742117806/CarrierProj/电力载波程序固件/(0201)carrier+wireless V1.3/readme.txt

国网13标准载波模块程序。

由于前期版本原因，本初始版本为：V4.00.

版本更新：
1、日期：20150520。
    初始版本号为V4.00。
2、日期：20150808。
    版本号：V4.03A。
    更新内容：主要更改两数据发送频率为：166.1KHz和177.1KHz ,本振为：284.0KHz.
      优化程序、屏蔽每8小时无访问时主动上报冻结数据。
3、日期：20150813
    版本号：V4.04A。
    更新内容：更改两频点为：164.4K 和 176.4K。本振为：285.7K。发送数据时，发到最后一次接收所在的时间片（相位）上去。
     
4、日期：20150819
    版本号：V4.04C
    更新内容：在单相电源上进行分时间片抄表时，底层帧可能被集中器模块解析成跨相数据。导致下次路由变成了跨相抄表。
