742117806/CarrierProj/资料/无线载波模块版本说明.docx

无线载波模块版本说明：

1、 此版本支持载波加无线，在载波发送完成后会通过无线发送（不管载波成功与否）;在接收的时候如果载波未接收到会去判断无线是否接收到，相当于载波无线同时收发。
2、 载波底层增加了对800psb的速率的支持，这由集中器路由模块决定是否使用，但是与以前版本兼容。所以默认还是最高400bps的通讯速率，采用的IO采样方式。
3、 在底层增加了纠错方式，这种方式将由集中器模块主动决定，默认是不使用的。在将来的测试中会使用。
4、 (0113)carrier+si4438 V1.2.hex文件是应用程序，是实际的载波模块（硬件版本4.04或以上）。如果硬件上不带无线座子，则只适用于载波通讯方式。
5、 此版本程序只适用于单相载波模块。
6、 (0108)si4438只用于无线测试.hex中用于无线测试使用。使用方式见相关文档。
