742117806/CarrierProj/原理图/iSPLC-9G-1X V4.06.pdf

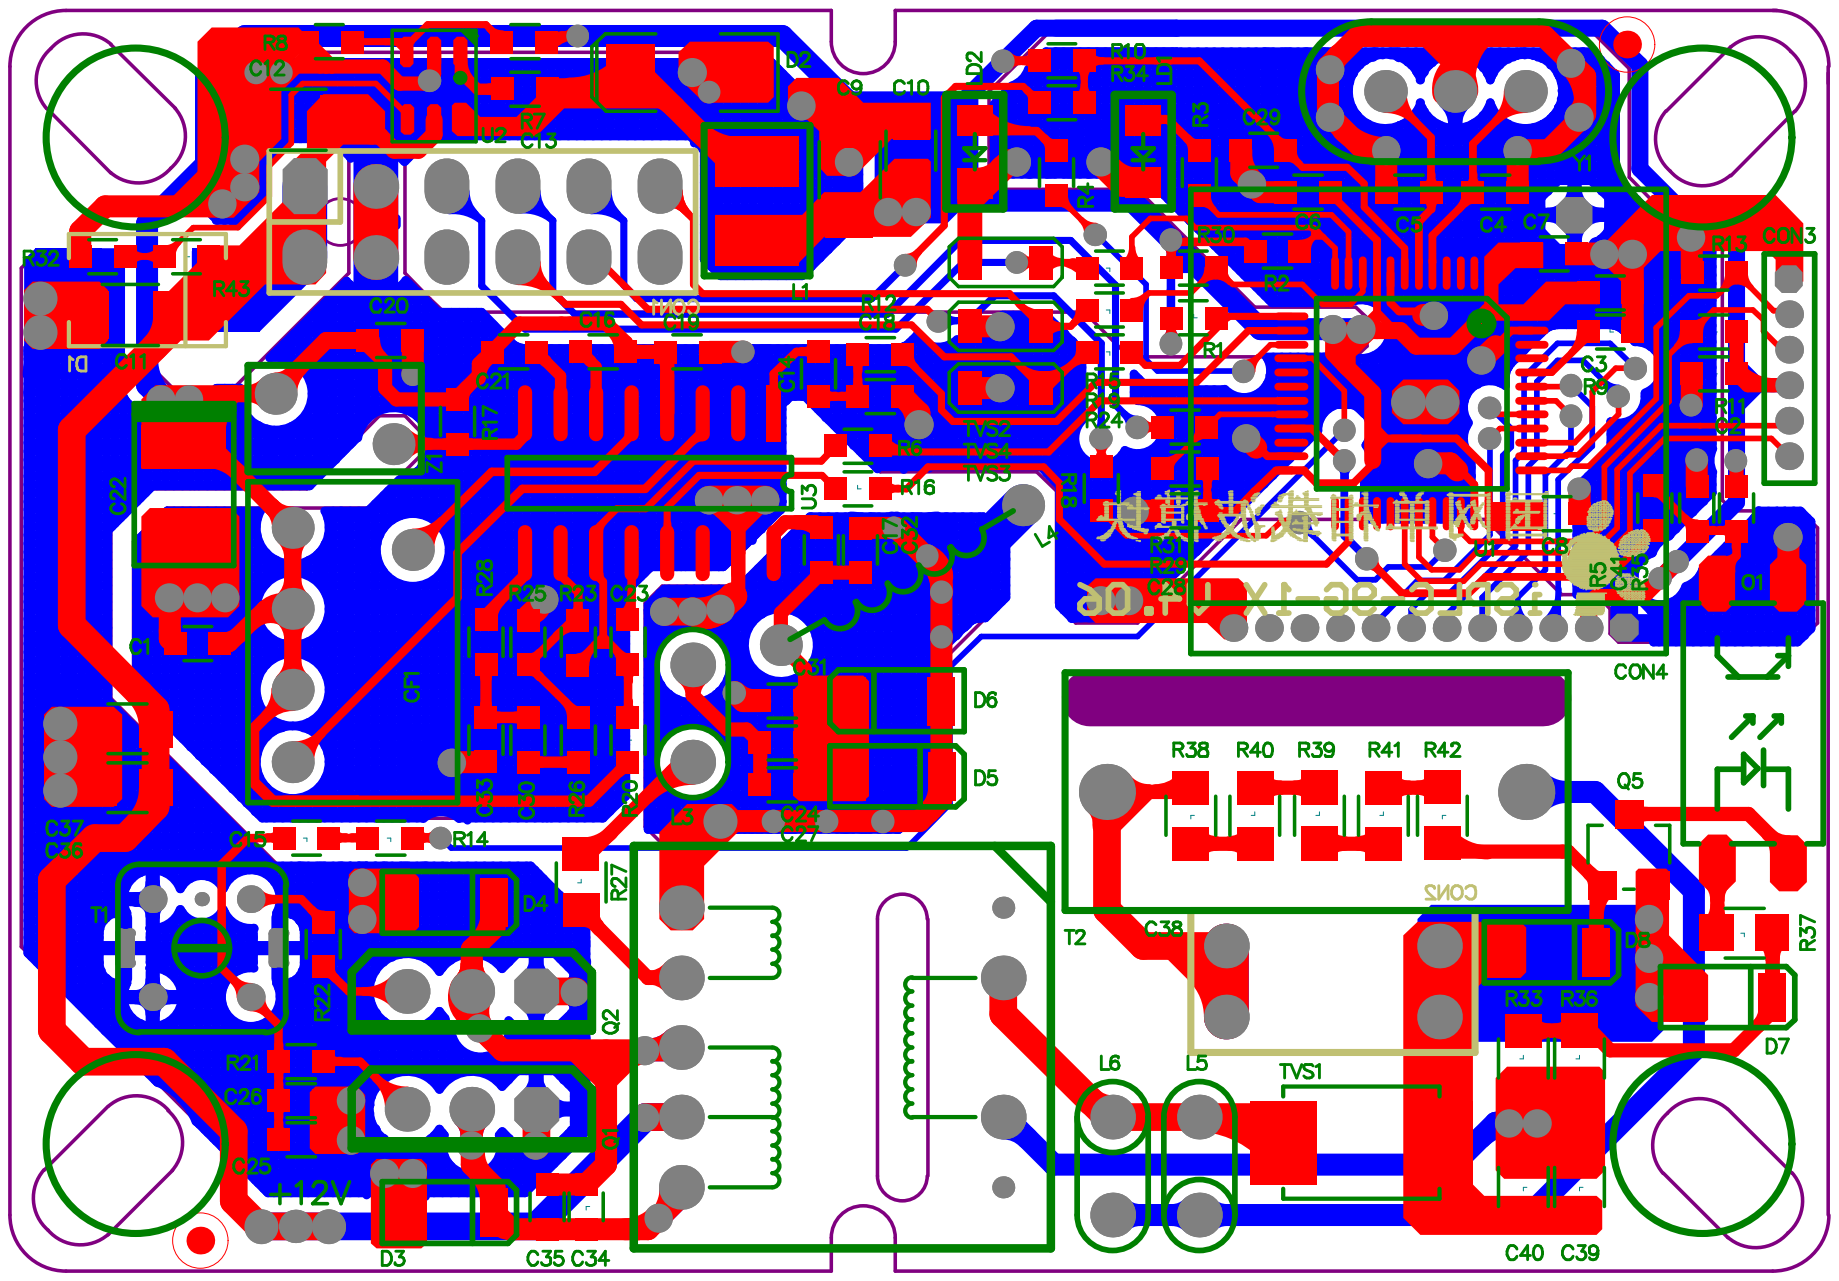
[picture p3: page 1]
