742117806/CarrierProj/原理图/零火开关/SS_dual_main-V4.2.pdf

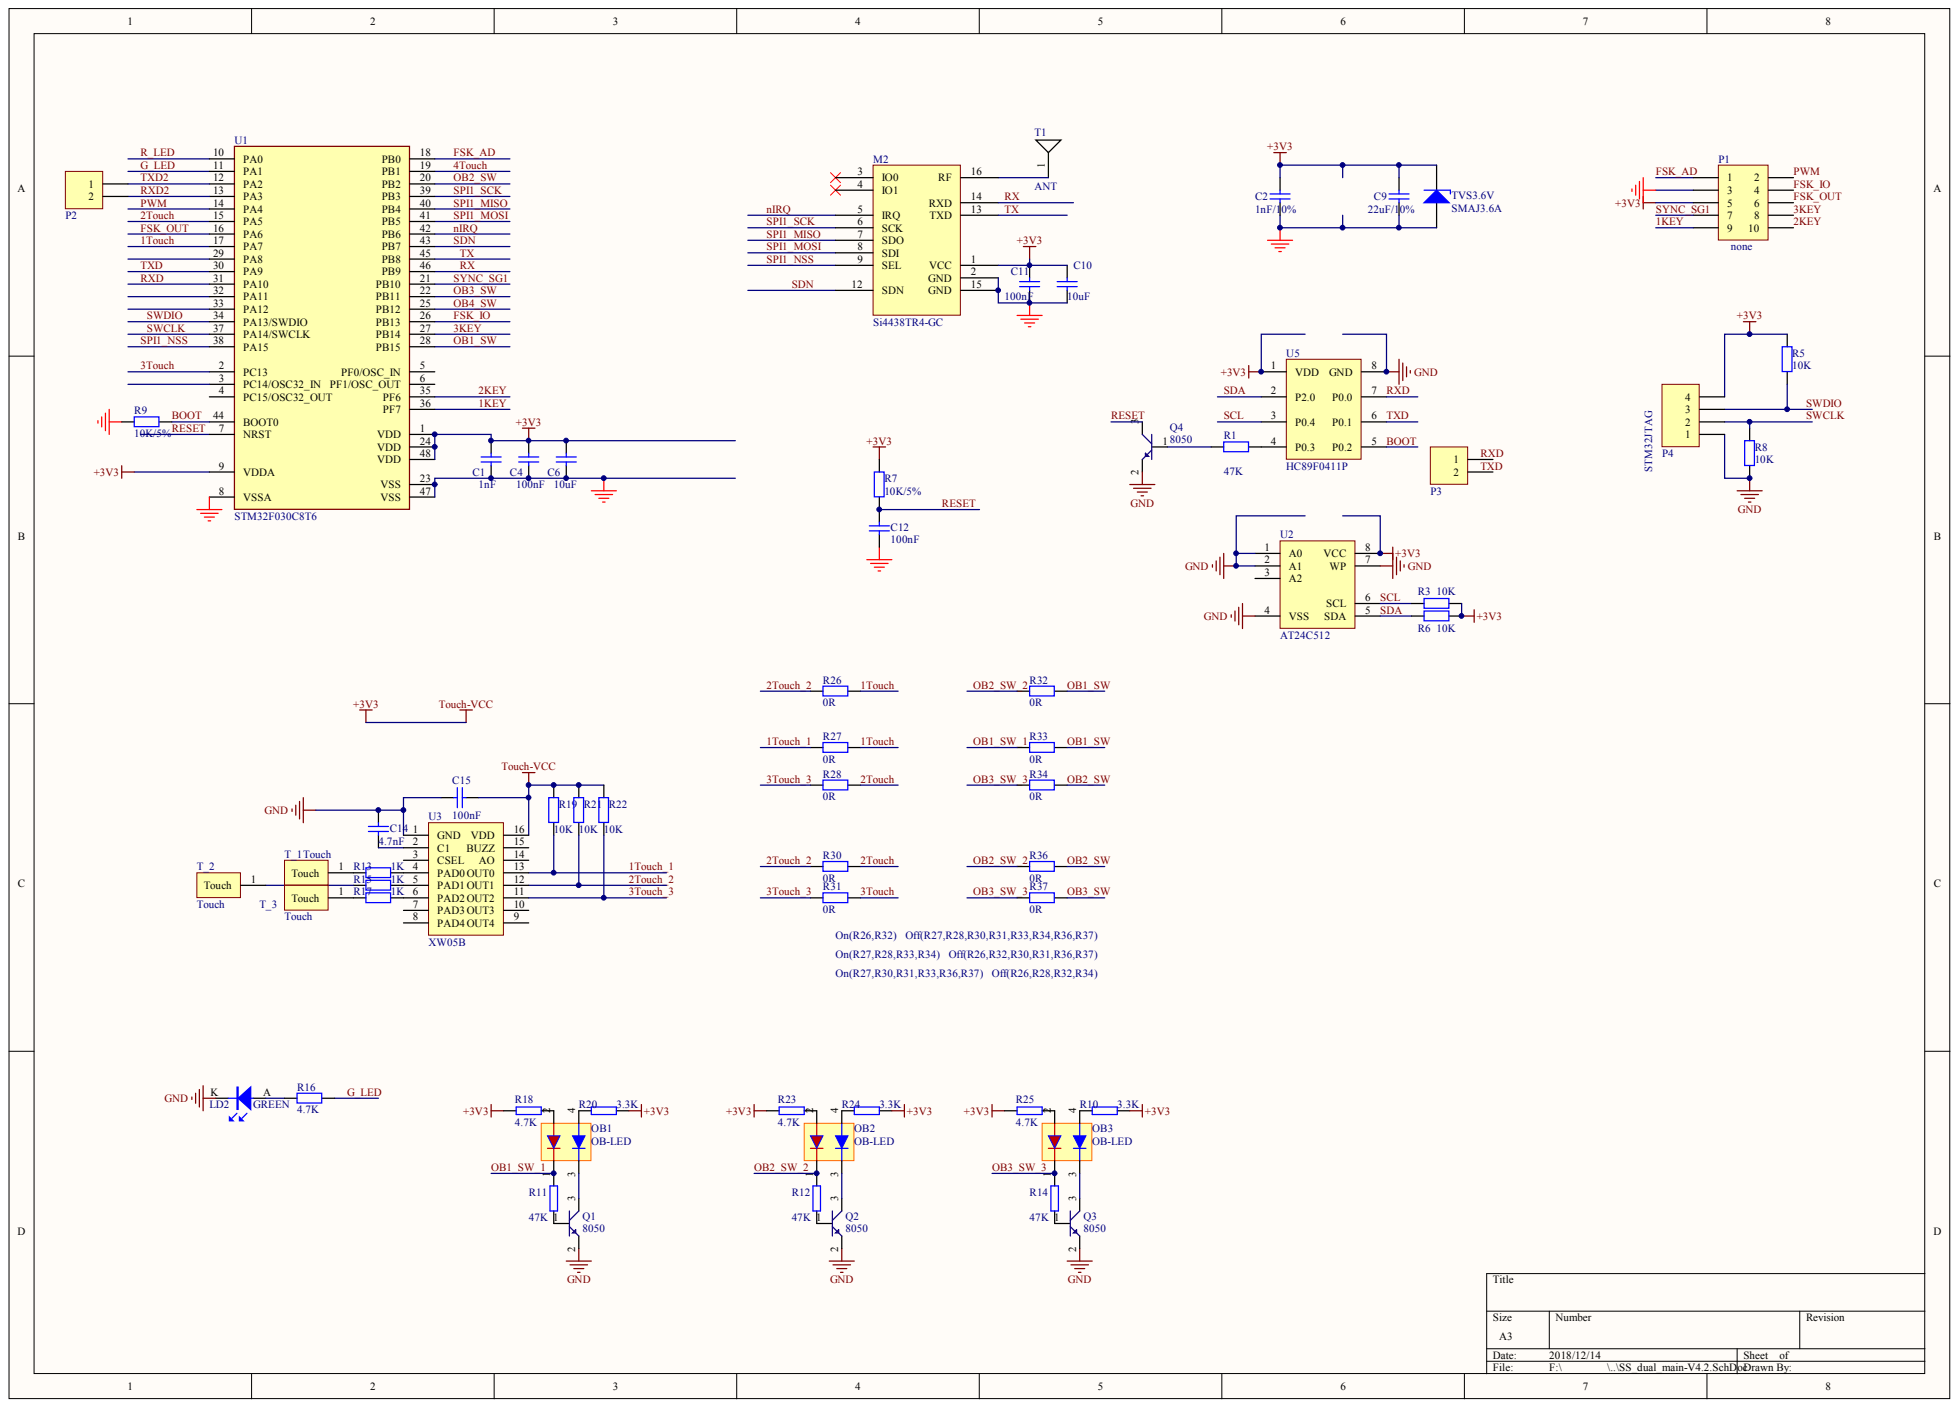
[picture p4: page 1]

R15 | 1K | PAD1 5
R17 | | 1K | PAD2 6
