742117806/CarrierProj/原理图/零火开关/SS_Power-dual_3_V4.1.pdf

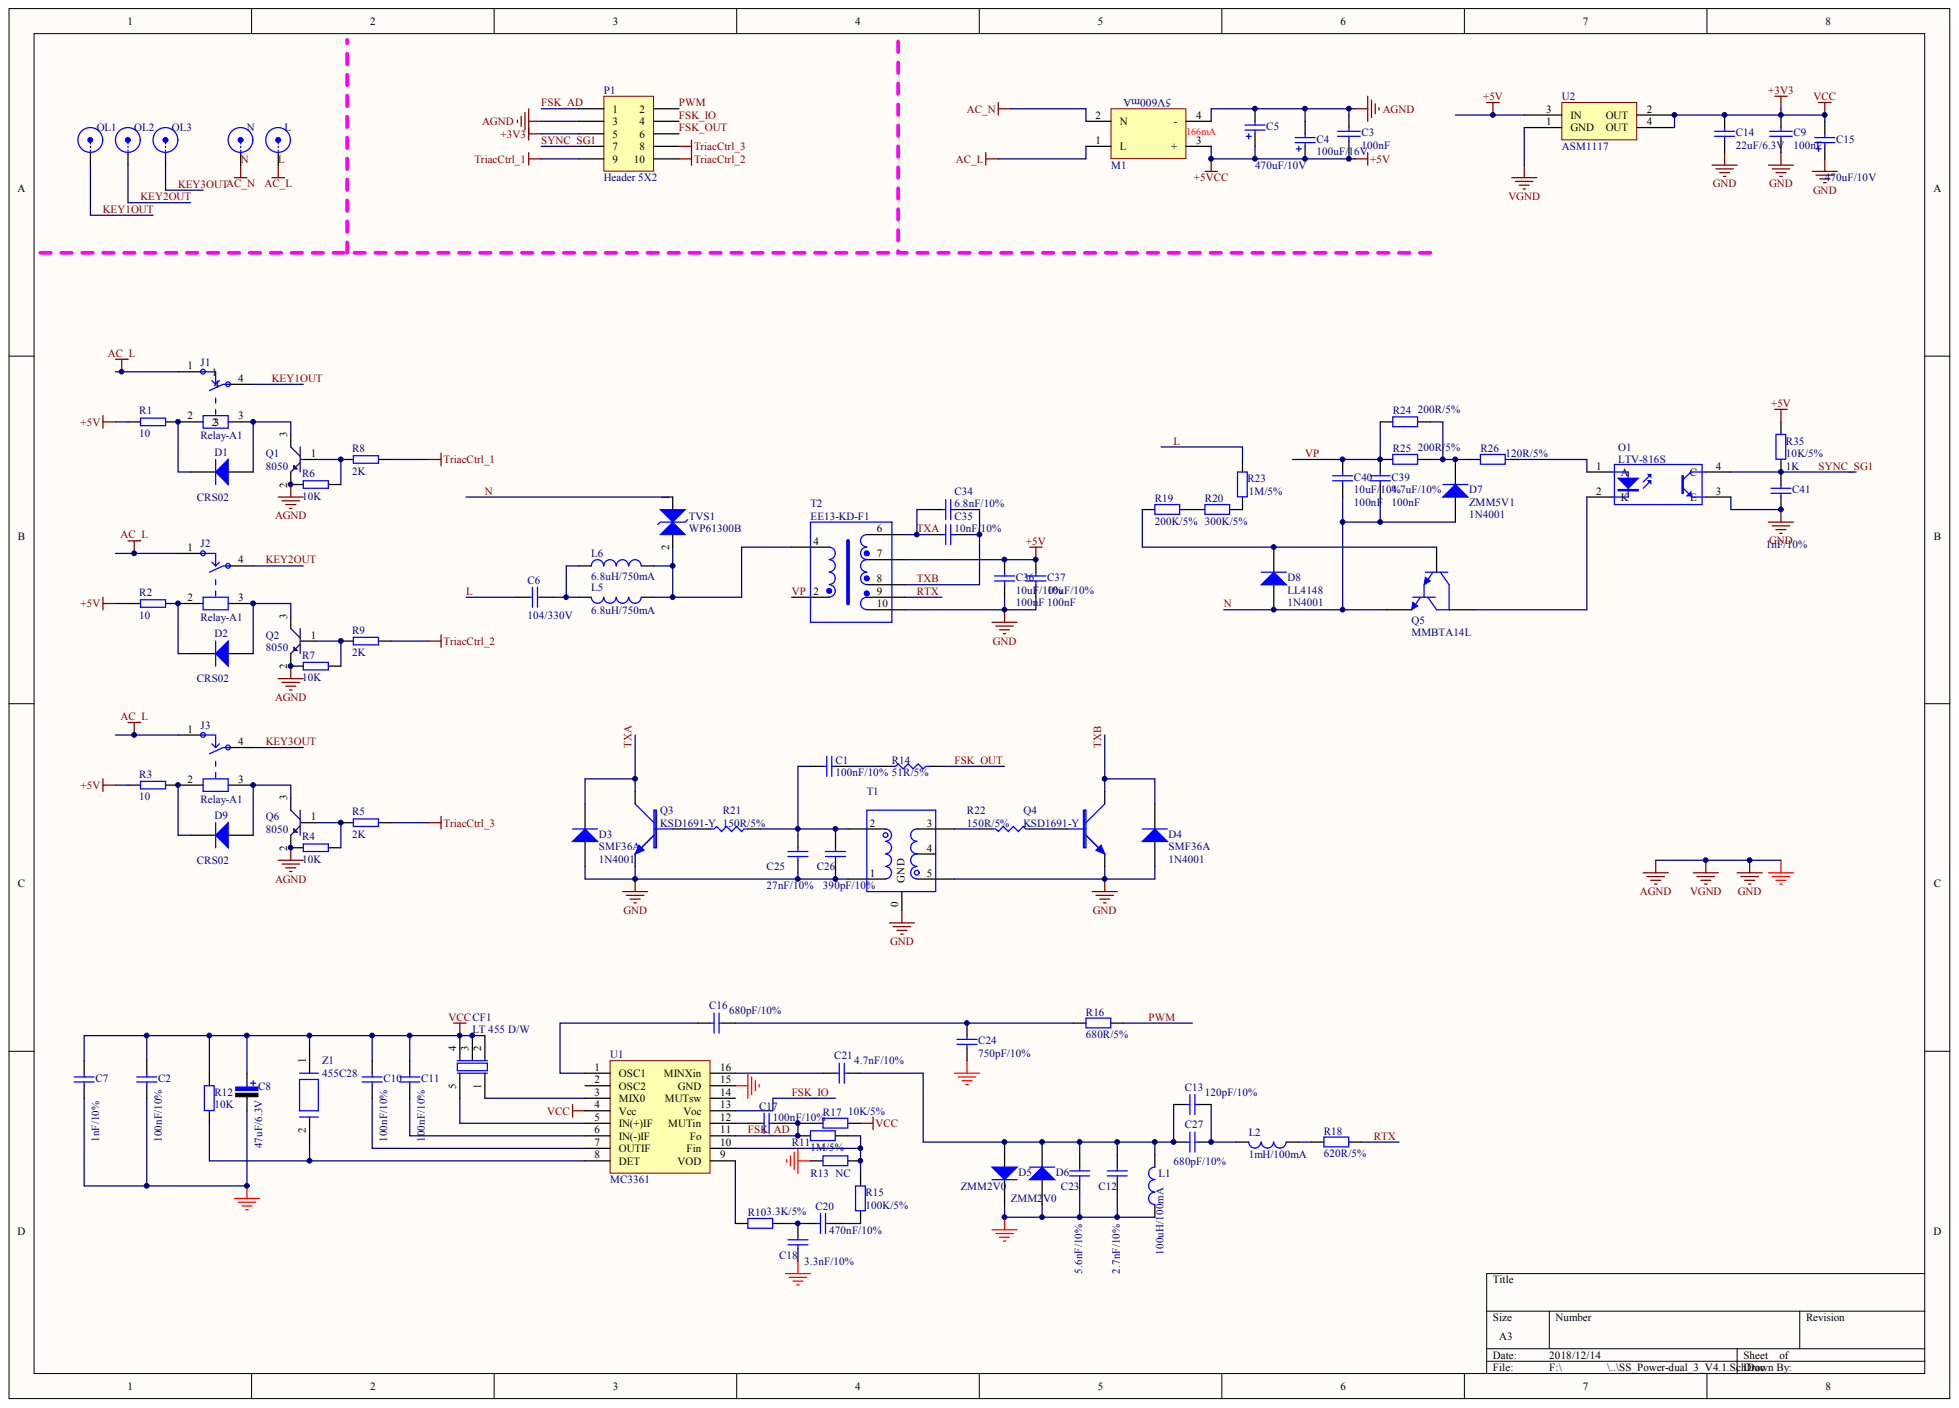
[picture p5: page 1]

OSC2 2 | FSK_IO

Vcc 4 | C17
