742117806/CarrierProj/原理图/零火开关/SS_Power-dual_3_V4.1b.pdf

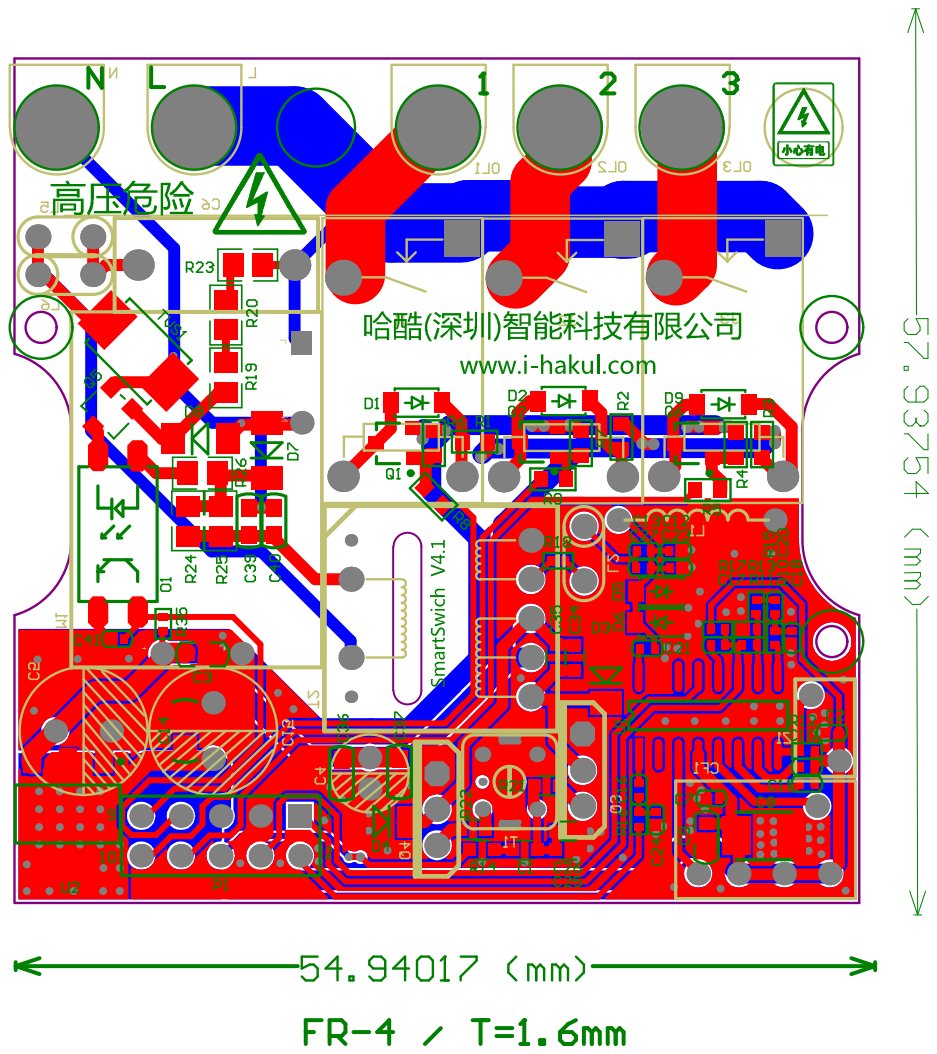
[picture p6: page 1]
