742117806/CarrierProj/原理图/iSPLC-9G-1X V4.05.pdf

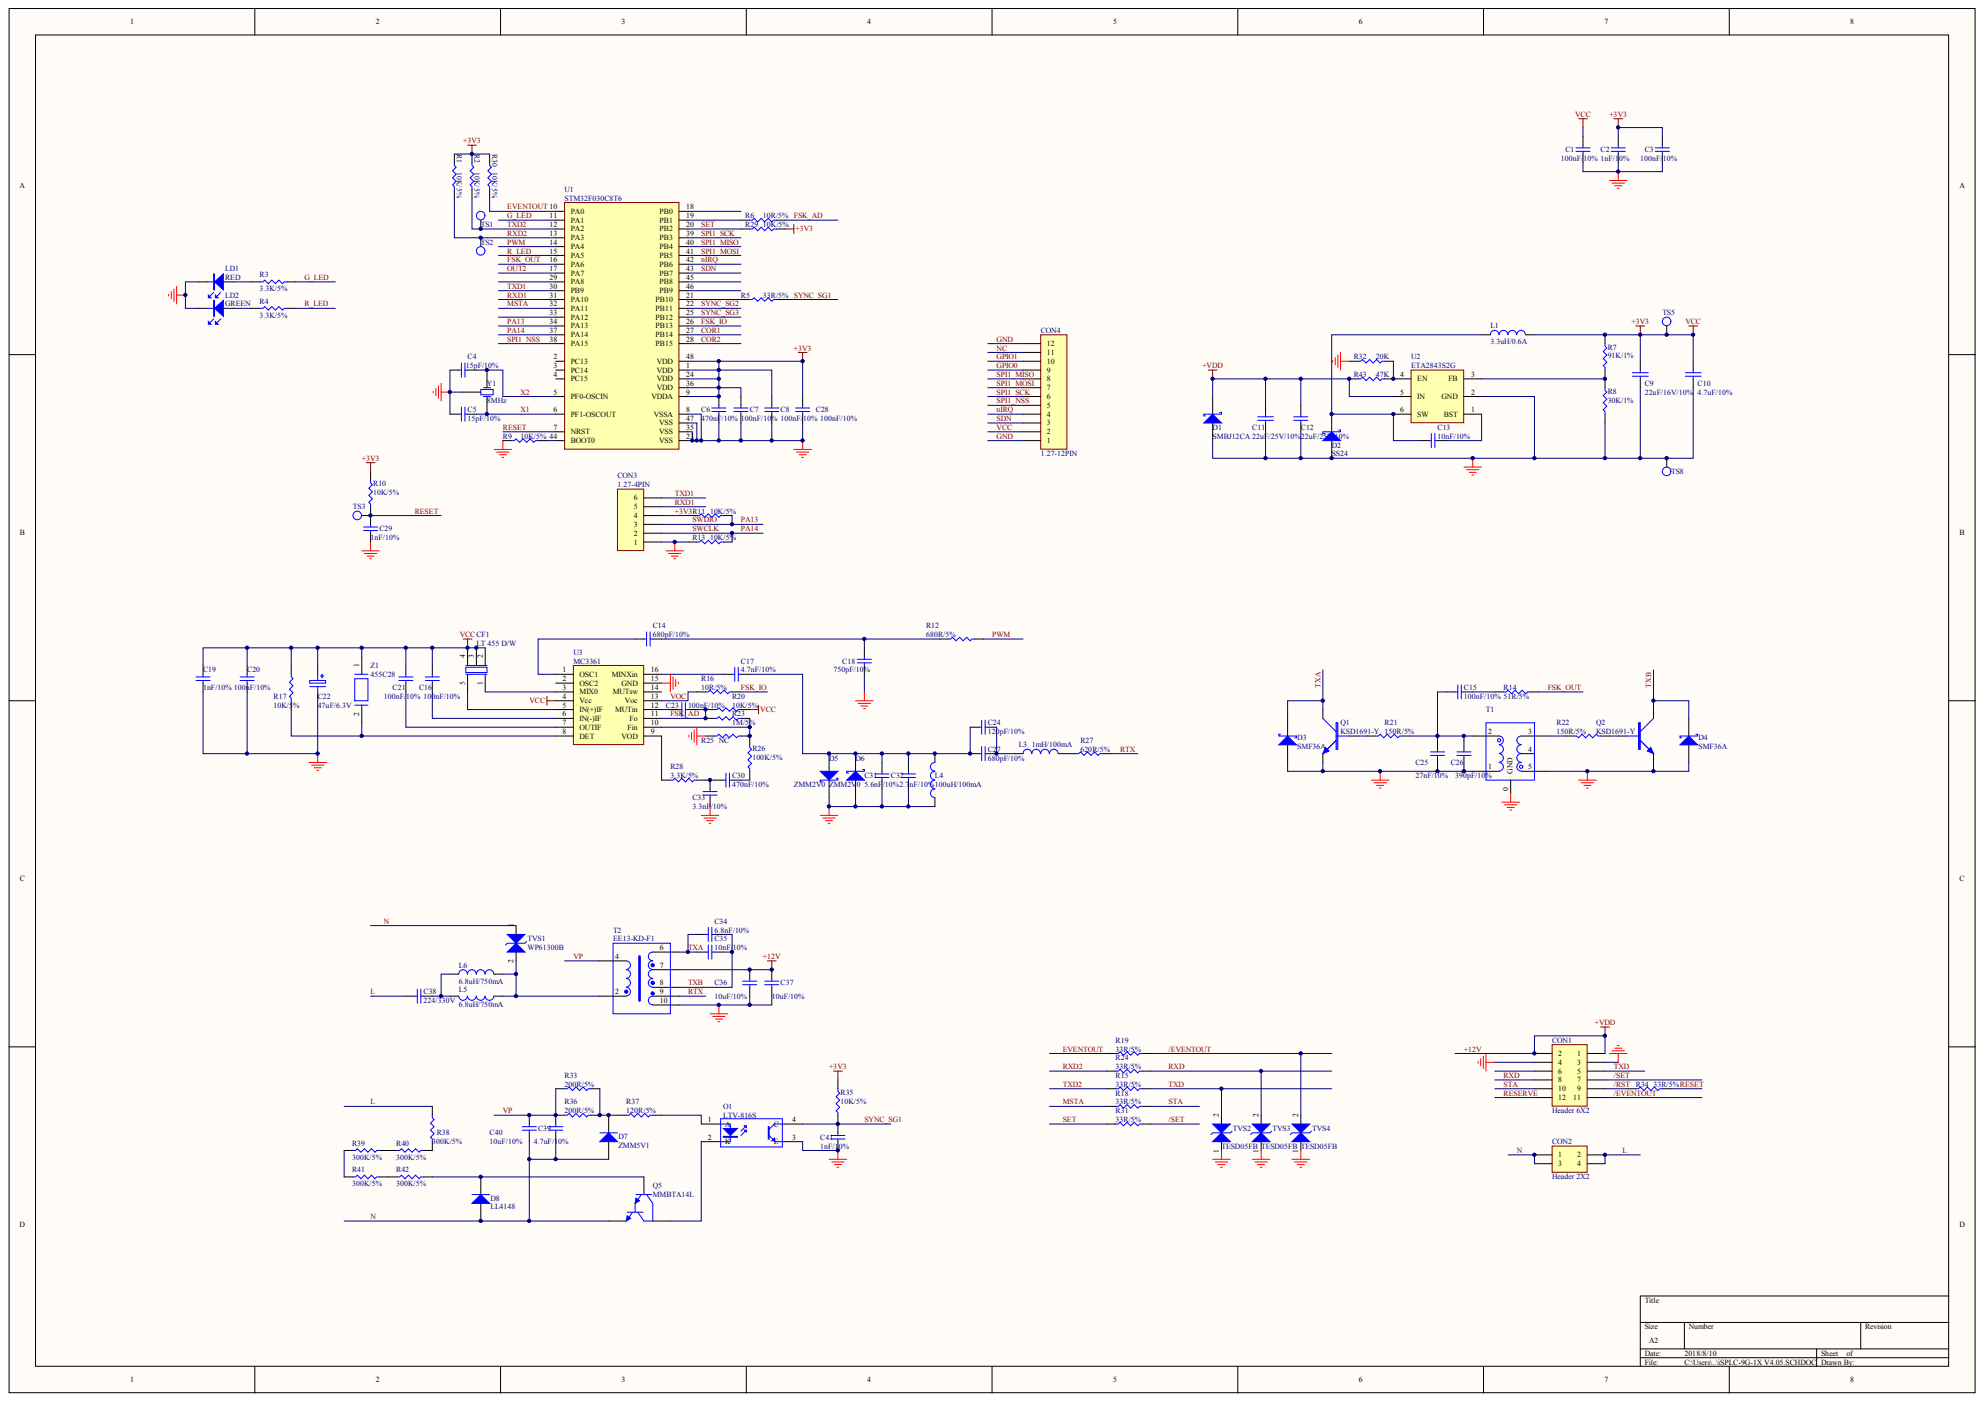
[picture p7: page 1]

IN(-)IF 6 | FSK_AD
